annachis04/Oscilator-de-audiofrecventa-cu-semnal-sinusoidal/Documentatia_P1_CHIS _Anna_432B.pdf

Universitatea Națională de Știință și Tehnologie POLITEHNICA București Facultatea E.T.T.I.
Anul universitar 2025-2026

# Circuite electronice fundamentale 2 - Proiect

# Proiectarea și realizarea unui

# oscilator de audiofrecvență cu

# semnal sinusoidal

N=1

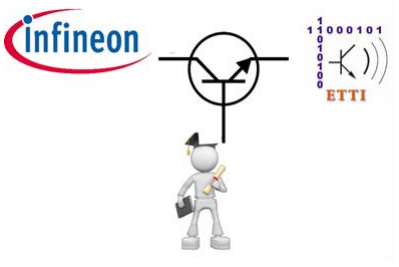
[picture p1: figure]

Coordonatori stiințifici: | Student: Chiș Anna
Prof. dr. ing Dragoș Dobrescu | Grupa:432B
Ș.l. dr. ing. Mădălin Moise

## Cuprins

Capitolul 5: Proiectarea și realizarea circuitului în tehnologie

5.2 Imaginea structurii de interconectare (layer-ul electric TOP).....19

### 5.3 Imaginea structurii de interconectare

### 5.4 Imaginea măștii de inscripționare (layer-ul neelectric SSTOP)...20

5.5.Imaginea măștii de protecție (layer-ul neelectric SMTOP).........20

## Capitolul 1: Date de proiectare

## Oscilator sinusoidal de audiofrecvență

Să se proiecteze şi realizeze practic un oscilator sinusoidal de audiofrecvenţă având următoarele caracteristici:

- Tensiunea de alimentare poate fi unipolară (Vcc=11 V) sau bipolară
(Vcc=11 V, Vee=-Vcc). Semnalizarea prezenței tensiunii cu LED;
- Tensiune de ieșire sinusoidală reglabilă cu amplitudinea va fi cuprinsă în intervalul 0-100 [mV];
- Frecvența semnalului de ieșire reglabilă în intervalul 100-1000 [Hz];
- Rezistența de sarcină 400 Ω (sarcină pur rezistivă);
- Pentru reţeaua de reacţie pozitivă se va utiliza unul dintre circuitele: Wien, Dublu Gama, Dublu T, T podit, cu 3 celule RC de defazare;

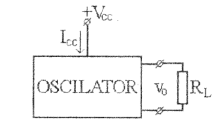
[picture p2: figure]

Schema bloc a oscilatorului

## Capitolul 2: Introducere în Proiectarea Oscilatoarelor

Proiectarea schemei unui oscilator se bazează pe principii fundamentale de electronică, integrând concepte studiate în cadrul disciplinelor DE (Dispozitive Electronice) și CEF (Circuite Electronice Fundamentale).

În esență, un oscilator este un sistem cu autoîntreținere, structurat pe trei piloni principali:

1. Elementul activ (Amplificatorul): Oferă energia necesară menținerii semnalului.
2. Reacția pozitivă (Calea de regenerare): Responsabilă pentru inițierea și susținerea oscilațiilor.
3. Reacția negativă (Calea de control): Utilizată pentru stabilizarea amplitudinii și controlul performanțelor amplificatorului.

### 2.1. Configurația și Funcționarea Sistemului

În practică, un oscilator este adesea privit ca un amplificator cu reacție negativă căruia i se aplică o buclă suplimentară de reacție pozitivă. Această arhitectură hibridă asigură atât stabilitatea punctului de funcționare, cât și condițiile necesare procesului de oscilație.

Rolul Reacției Pozitive

Reacția pozitivă este
mecanismul critic prin care o fracțiune din semnalul de ieșire este reinjectată la intrare în fază cu semnalul original. Acest proces de feedback cumulativ are următoarele implicații:

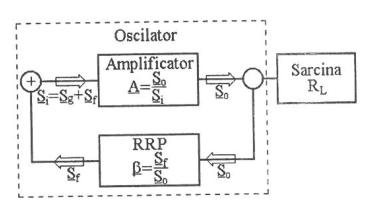
[picture p3: figure]

- Auto-susținerea: Semnalul readus la intrare este re-amplificat succesiv, ducând la o creștere progresivă a amplitudinii.
- Intrarea în saturație: Spre deosebire de amplificatoarele liniare, unde reacția pozitivă este evitată pentru a preveni instabilitatea, în cazul oscilatoarelor, acest fenomen este exploatat controlat. Deoarece un amplificator fizic nu poate depăși tensiunile de alimentare (+Vcc și VEE), semnalul se va stabiliza oscilând între aceste limite de saturație.

Rețeaua de Reacție Pozitivă (RRP)

RRP-ul nu este doar un simplu conductor, ci un circuit selectiv (de obicei un filtru RC) cu două funcții vitale:

1. Amorsarea oscilațiilor: Sistemul pornește de la zgomotul termic inerent componentelor electronice. RRP selectează o componentă spectrală din acest zgomot și o trimite spre amplificare până la atingerea regimului permanent.
2. Determinarea frecvenței: Prin structura sa constructivă (valorile componentelor R și C), rețeaua impune frecvența precisă la care defazajul este nul, definind astfel frecvența de lucru a oscilatorului.

Concluzie: Rețeaua de reacție pozitivă funcționează ca un selector de frecvență și un motor al sistemului, transformând un zgomot aleatoriu într-un semnal periodic stabil.

### 2.2. Reacția Negativă (RRN)

Spre deosebire de reacția pozitivă, care favorizează instabilitatea necesară amorsării, reacția negativă are rolul de a stabiliza sistemul. Aceasta se opune creșterii necontrolate a semnalului, permițând ajustarea precisă a factorului de amplificare al oscilatorului.

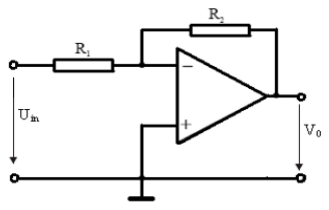
[picture p4: figure]
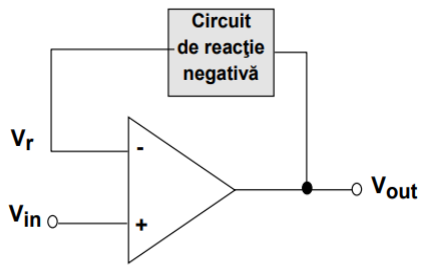
[picture p5: figure]

Figura 1 | Figura 2

În configurația din Figura 2, borna neinversoare este conectată la masă, în timp ce semnalul este aplicat pe borna inversoare. În această structură:

- Rezistorul R1 limitează curentul de intrare.
- Rezistorul R2 stabilește bucla de reacție negativă.

Relația fundamentală pentru tensiunea de ieșire (Vo) și amplificarea în buclă închisă (A) este:

V0 =

−R2
R1
* Uin | A = V0 Uin = −R2
R1

Prezența semnului minus confirmă natura inversoare a etajului, indicând un defazaj de 180 de grade între intrare și ieșire.

Funcțiile principale ale RRN în cadrul oscilatorului:

1. Stabilizarea amplificării: Menține câștigul sistemului la o valoare fixă, independentă de variațiile parametrilor interni ai componentelor.
2. Controlul liniarității: Prin introducerea unor elemente de limitare în bucla de reacție, se previne intrarea brutală în saturație, asigurând un semnal de ieșire cu distorsiuni minime.

### 2.3. Amplificatorul Operațional și Arhitectura Sistemului

Pentru implementarea circuitului, utilizăm un amplificator operațional (AO), caracterizat prin:

- Impedanță de intrare foarte mare: Previne încărcarea etajelor anterioare.
- Impedanță de ieșire redusă: Permite transferul optim de putere către sarcină.
- Câștig în buclă deschisă ridicat: Esențial pentru procesarea semnalelor de mică amplitudine.

Un aspect practic pentru identificarea reacțiilor este conexiunea la pinii AO:

- Conexiunea la borna inversoare (-) generează reacție negativă.
- Conexiunea la borna neinversoare (+) generează reacție pozitivă.

Proiectarea Etajelor Cascadata

Pentru a obține un oscilator performant, vom structura circuitul în trei blocuri funcționale:

- Blocul de intrare: Proiectat cu o impedanță ridicată pentru a izola sursa de semnal (sau zgomotul termic inițial) și a nu perturba etajele următoare.
- Blocul de amplificare: Reprezintă "inima" sistemului. Acesta trebuie să furnizeze un câștig suficient pentru a compensa atenuările din rețeaua de reacție, respectând Criteriul lui Barkhausen pentru menținerea oscilațiilor sinusoidale.
- Blocul de ieșire (Buffer): Are rolul de adaptare a sarcinii. Acesta nu modifică amplitudinea semnalului, ci asigură curentul necesar la ieșire, protejând etajul de amplificare de variațiile impedanței de sarcină.

## Capitolul 3: Considerente teoretice

## 3.1 Condiția de oscilație Barkhausen

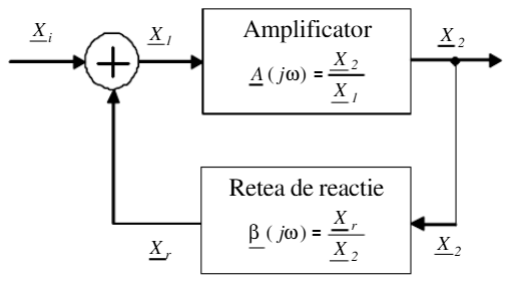
[picture p6: figure]

Notăm cu A câștigul amplificatorului, iar cu β funcția de transfer a RRP, dependentă de frecvență și care fixează frecvența de oscilație. Circuitul devine un oscilator, daca îndepărtând semnalul de excitație(Sg=0), la ieșire se obține un semnal (So, finit). Acest lucru semnifică faptul că aplificarea cu reacție Af = Sg/ So = A / (1- βA) este infinita, rezultând:
A * β(0)= 1 - condiția Barkhausen Pe de altă parte, câștigul este independent de frecvență. Ca urmare, se impune suplimentar ca Im{ β(0)}= 0 ; notând modulele câștigului și funcției de transfer cu A, respectiv β( 0) condiția Barkhausen se explicitează: A*β(0)=1
| A+B= 0/2π
A si B reprezintă defazajele introduse la f=f0 de amplificator, rspectiv RRP.
Ținând cont de factorii ce duc la variația amplificării (temperatura, tensiunea de alimentare etc.) sunt posibile urmatoarele cazuri: A<1/ β(0), cand nu apar oscilații;
A<1/ β(0), când semnalul de la ieșire este distorsionat; A=1/ β(0), când nu se realizează amorsarea/ stabilizarea oscilațiilor.
Amorsarea presupune debutul oscilațiilor,creșterea amplitudinii semnalului de frecvență 0 până la valoarea Vosc – amplitudinea în regim permanent de oscilație. Stabilizarea presupune la rândul ei menținerea amplitudiniii la valoarea Vo=Vosc= const.
Concret, amorsarea și stabilizarea oscilațiilor sunt posibile dacă si numai dacă amplificarea este o funcție descrescătoare de amplitudinea semnalului generat la ieșire, lucru ilustrat și în figura.
Din calcule teoretice rezulta necesitatea unei amplificari mai mare de 3 pentru schema pe care ne propunem sa o facem si anume, un oscilator cu punte Wien.

## 3.2. Limitarea amplitudinii de oscilație

Mecanismul de limitare asigura mentinerea oscilatiilor la un nivel controlat. Astfel, exista mai multe metode:
- Un termistor sau bec, ce se bazeaza pe variatia rezistentei.
- Un dipol din diode, ori 2 diode simple antiparalel, ori 2 zener in antiserie
- Un control automat cu TEC-J

- In esenta, toate astea de mai sus vor intra in relatia amplificarii 1+r2/r1, putand fi ori termenul r2 ori r1. Acestia variind intr-un anumit fel, automat si amplificarea va varia si ea. De obicei noi vrem ca amplificarea sa scada la un moment dat si sa se mentina la o valoare stabilita de noi, pentru a evita saturarea.

## 3.3. Rețele RC

## - Rețeaua Wien

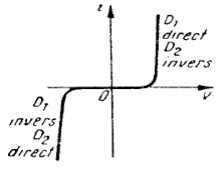
[picture p7: figure]

Rețeaua Wien este ilustrată în figura, schema din stânga pentru transfer în tensiune, cu functia de transfer in stanga
Presupunând această rețea conectată la un amplificator ideal de tensiune, se observă că raporturile R1/ R2 și C2/ C1 trebuie menținute constante atunci când se reglează frecvența, în

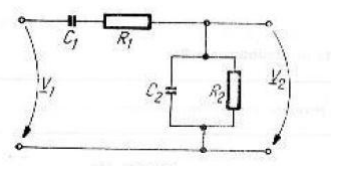
[picture p8: figure]

caz contrar modificându-se valoarea amplificării si deci amplitudiea oscilațiilor.
Se preferă deci să se aleagă R1= R2= R și C2= C1= C, astfel încât frecvența de oscilație devine 1/ (2*π*R*C), amplificarea în tensiune din condiția Barkhausen fiind egală cu 3.Folosind programul de simulare LTspice, putem observa curba de atenuare specifică.

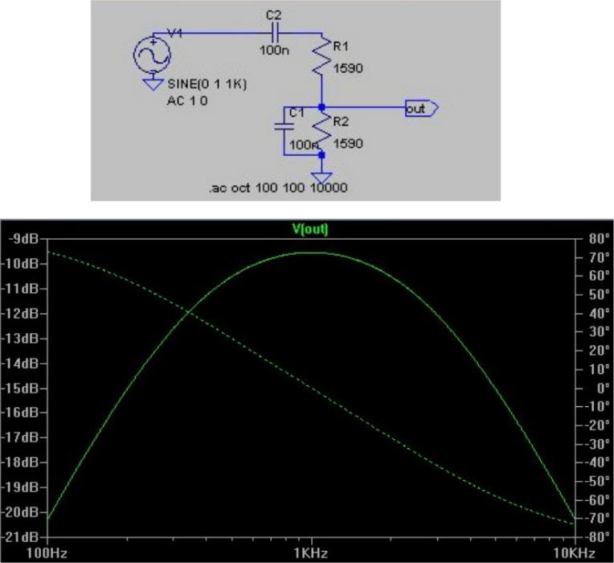
[picture p9: figure]

## Rețeaua dublu T

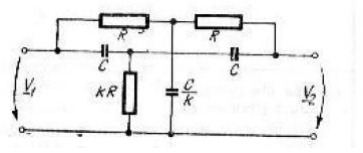
[picture p10: figure]

Figura de mai sus ilustrează rețeaua dublu T, cu transfer în tensiune, iar funcția de transfer este si ea prezentată mai jos:

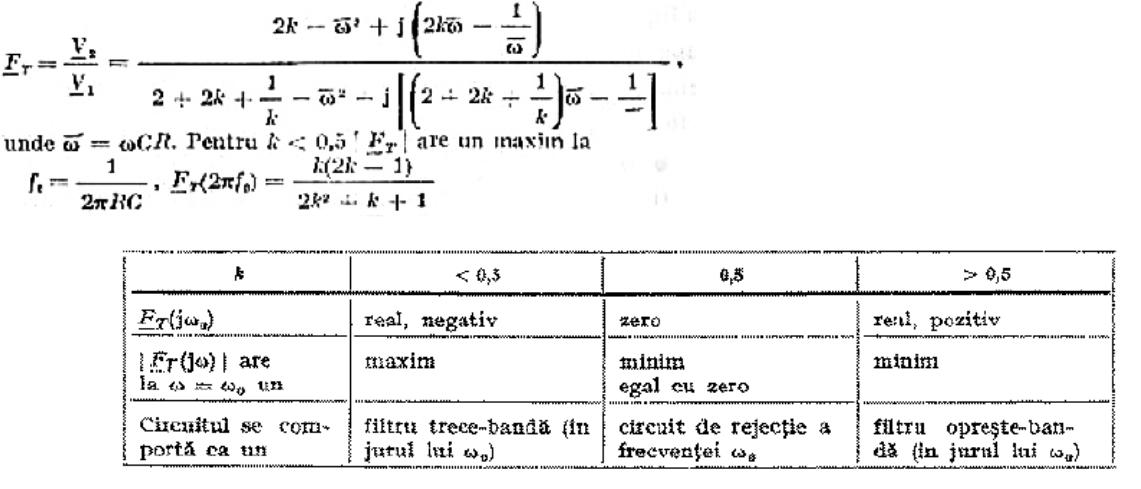
[picture p11: figure]

La frecvența caracteristică, funcția de transfer în tensiune este reală, fiind pozitivă pentru k>0,5, negativă pentru k<0,5 și zero pentru k=0,5. Cele 3 cazuri sunt sintetizate in imaginea de mai sus. Daca rețeaua operează ca un filtru trece-bandă, atunci ea poate fi folosită în bucla de reacție pozitivă a unui oscilator. Dacă rețeaua lucrează ca un filtru oprește-bandă, atunci ea trebuie inclusă în bucla de reacție negativă, oscilatorul mai necesitând o buclă de reacție pozitivă neselectivă.
Simulările pentru o rețea dublu T, pentru k=0,159 sunt prezentate mai jos, folosind LTspice:

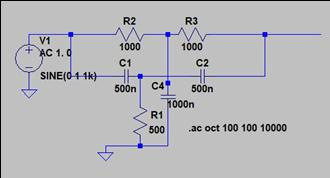
[picture p12: figure]

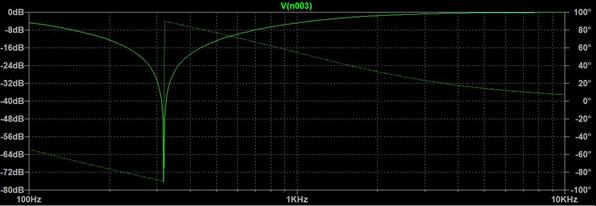
[picture p13: figure]

Rețeaua T-podit

Rețeaua T-podit are proprietăți asemănătoare cu rețeaua dublu T, cu o selectivitate mai slabă, dar cu avantajul că frecvența se poate varia cu un potențiometru, ca la rețeaua Wien.Schema este prezentă mai jos pentru un k=0,054 și funcția de transfer alăturată.

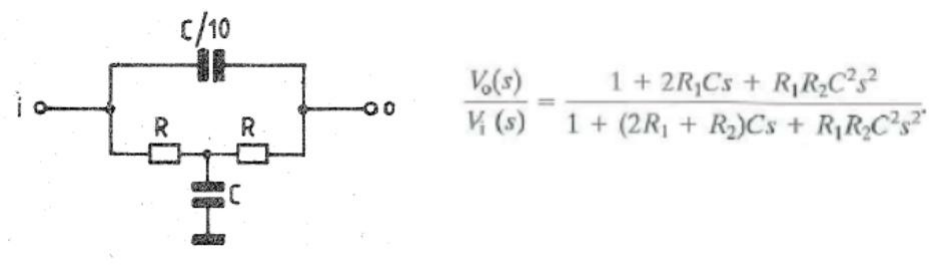
[picture p14: figure]
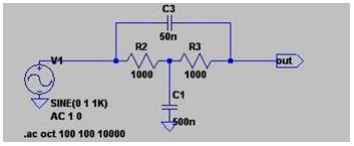
[picture p15: figure]

## Capitolul 4: Proiectare 4.1. Schema electrica a montajului

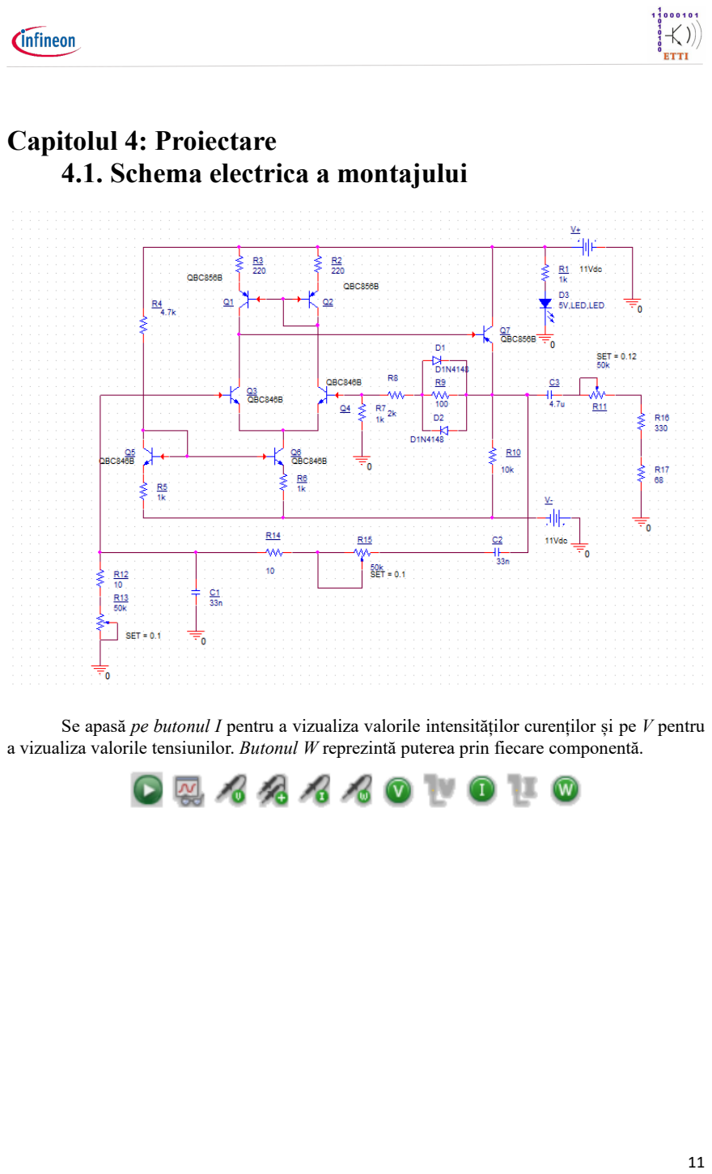
[picture p16: page 11]

Se apasă pe butonul I pentru a vizualiza valorile intensităților curenților și pe V pentru a vizualiza valorile tensiunilor. Butonul W reprezintă puterea prin fiecare componentă.

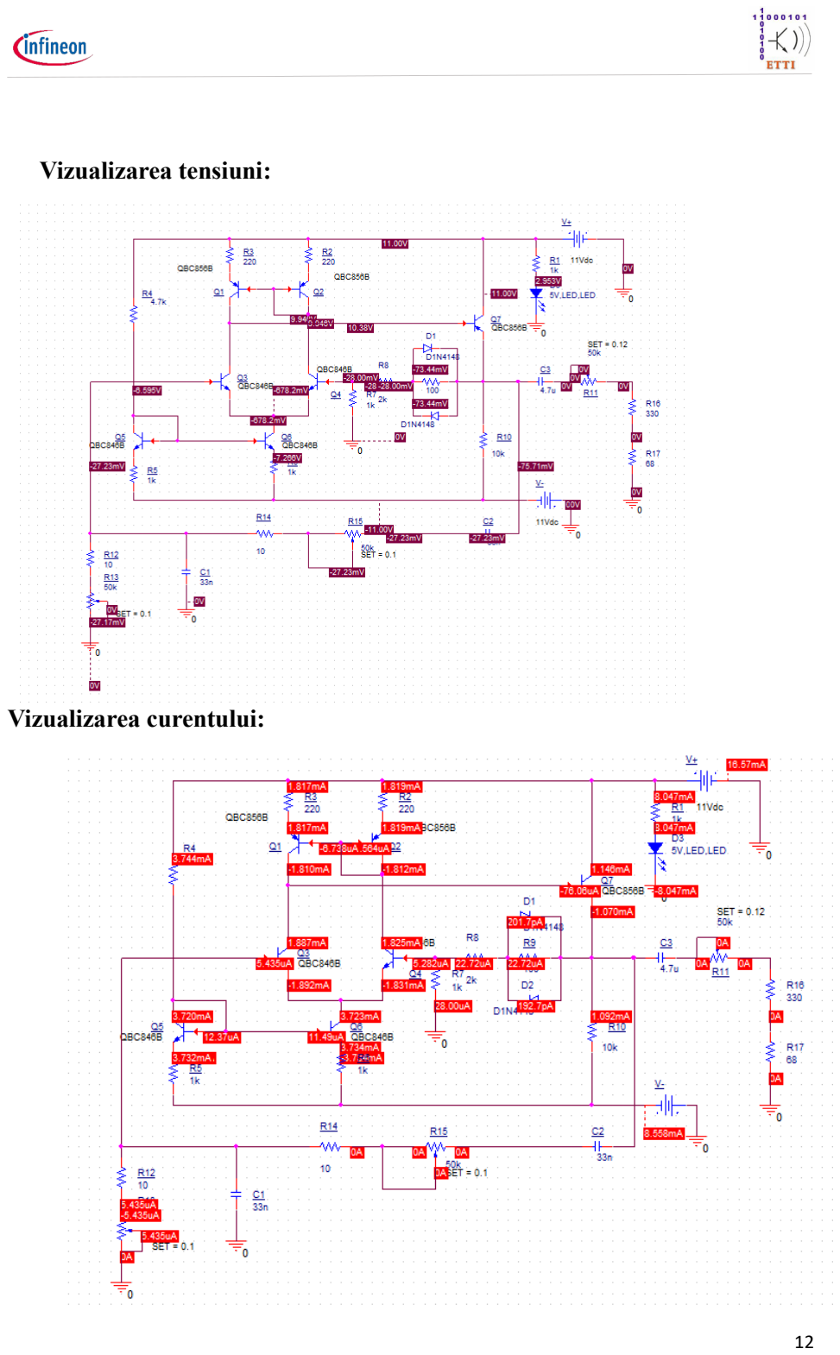
[picture p17: page 12]

Vizualizarea tensiuni:

Vizualizarea curentului:

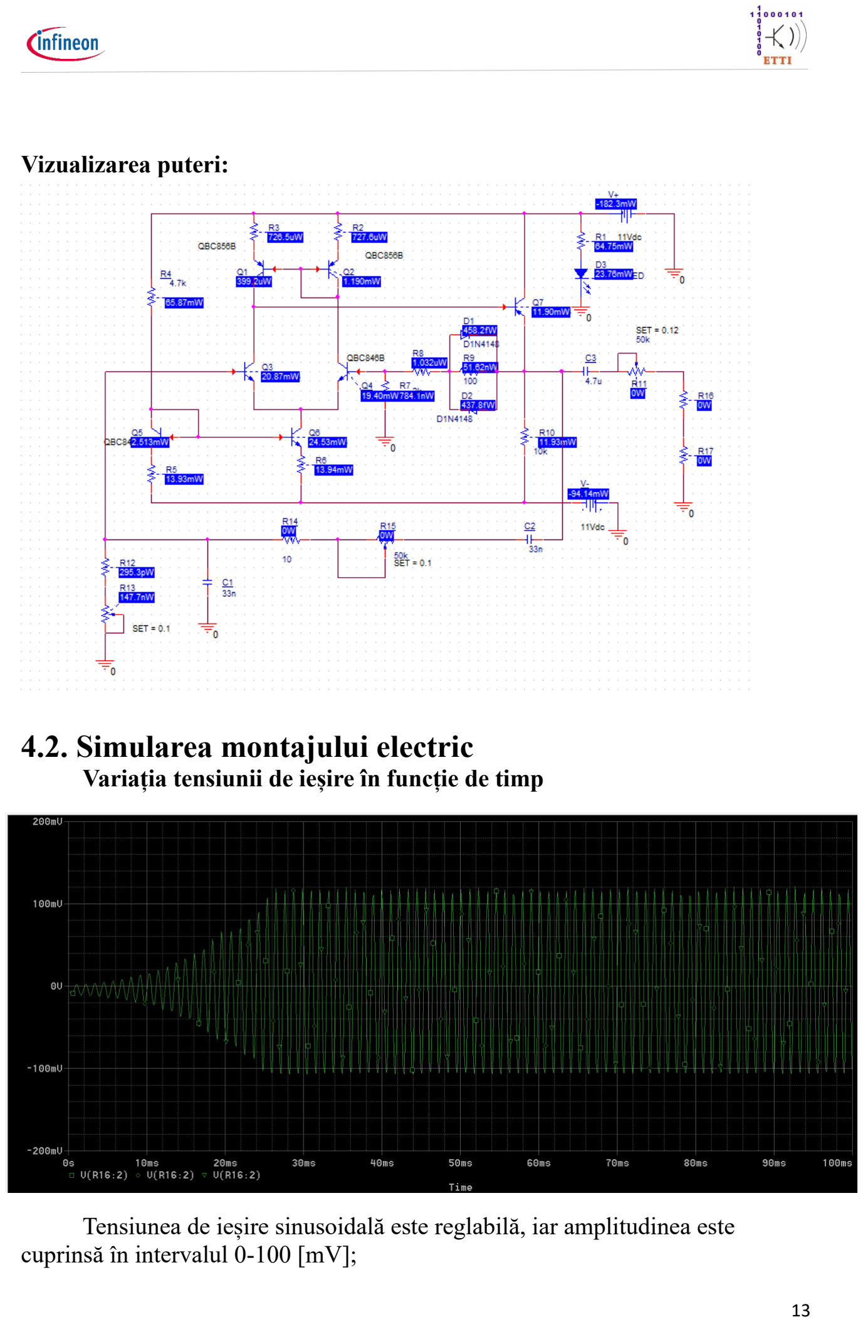
[picture p18: page 13]

Vizualizarea puteri:

## 4.2. Simularea montajului electric

Variația tensiunii de ieșire în funcție de timp

### Tensiunea de ieșire sinusoidală este reglabilă, iar amplitudinea este

cuprinsă în intervalul 0-100 [mV];

Frecvența de oscilatie
Frecvența semnalului de ieșire este reglabilă în intervalul 100-1000 [Hz];

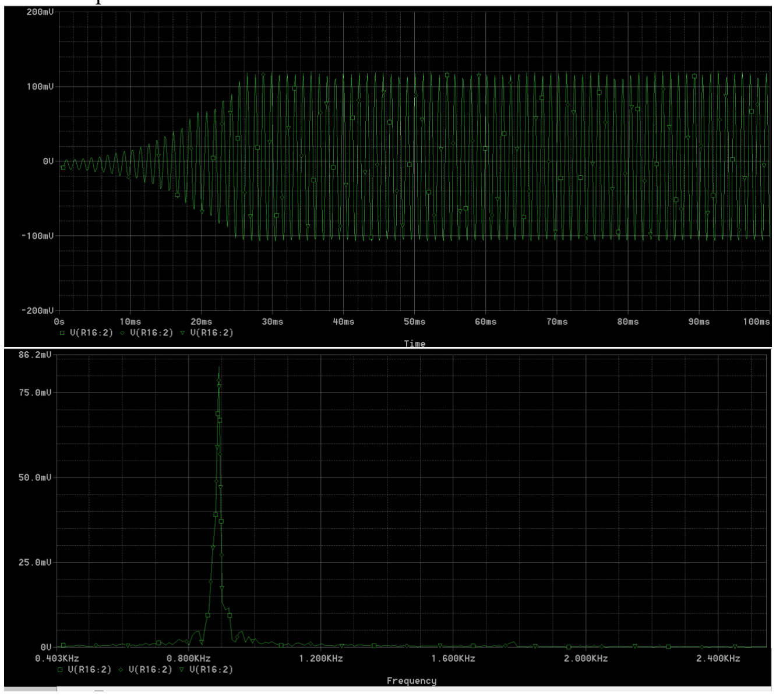
[picture p19: figure]

### Semnalul pentru f=1 kHz:

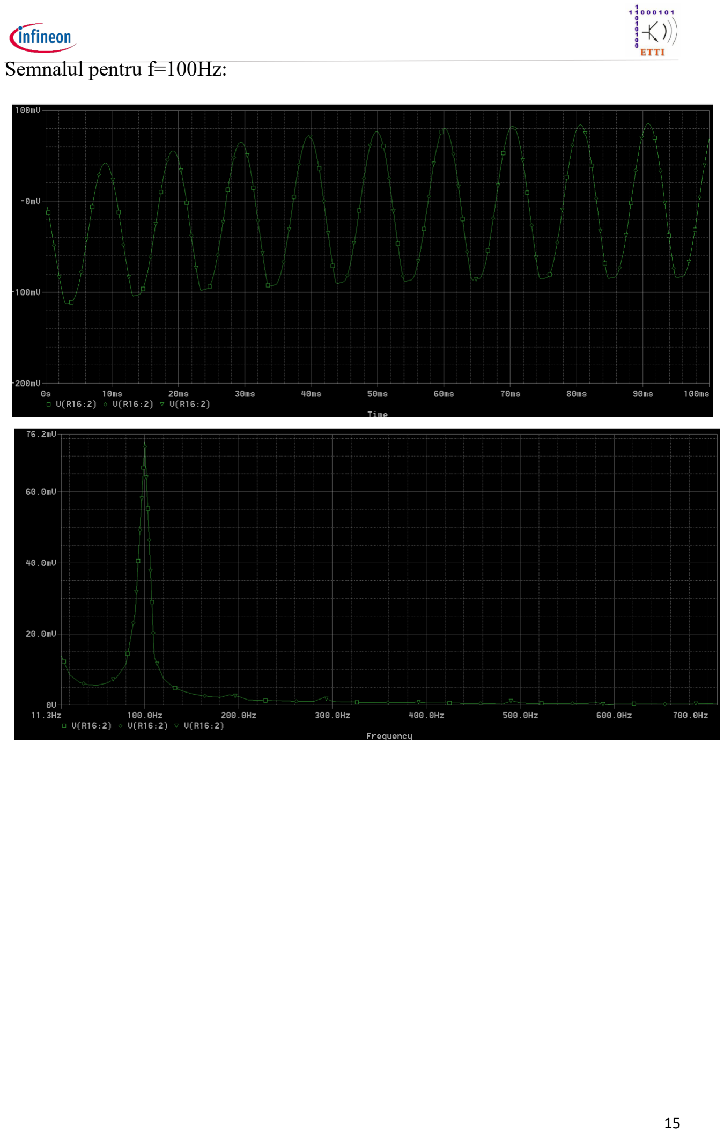
[picture p20: page 15]

### Semnalul pentru f=100Hz:

## 4.3. Punctul static de funcționare

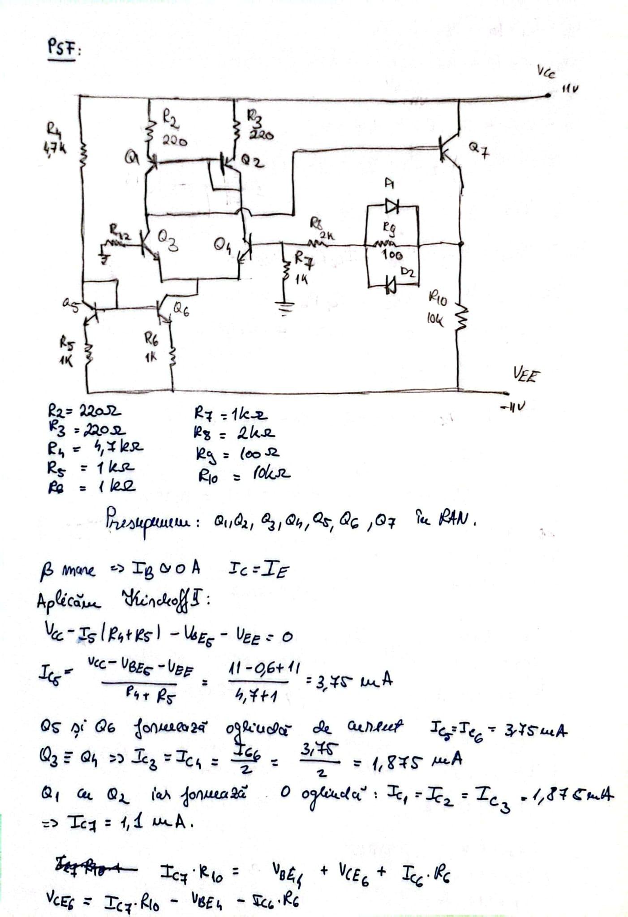
[picture p21: figure]
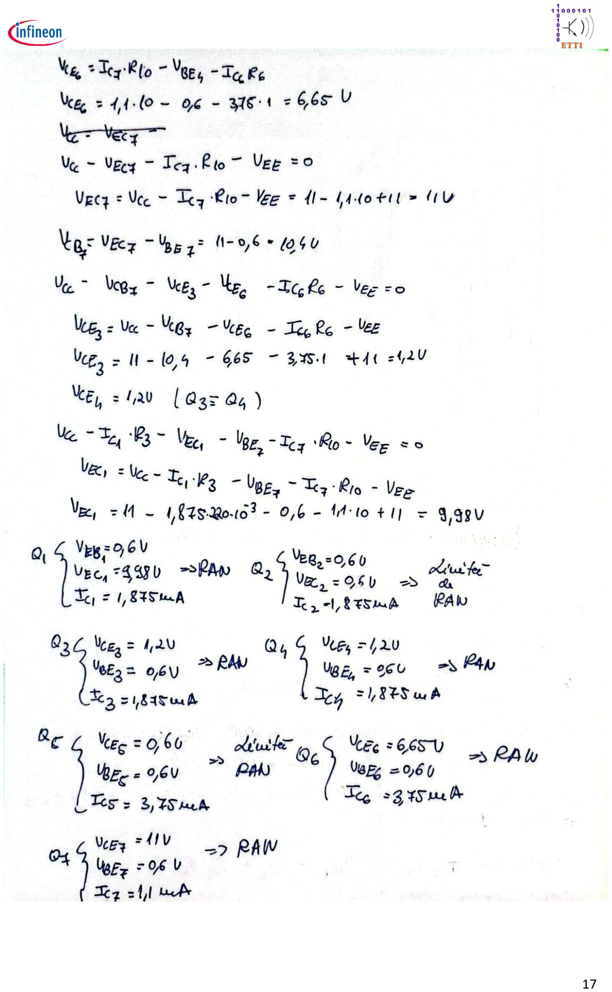
[picture p22: page 17]

## 4.4. Bill of Materials

Nr. Crt. | Nume | Catalog | Cod distrib | Nume prod | Prod | Clasă | Cantitate
5 | 10 | (LINK) (https://www.tme.eu/ro/details/smd0805-10r/rezistente-smd-0805/royal-ohm/0805s8j0100t5e/) | SMD0805-10R-5% | 0805S8J0100T5E | ROYAL OHM | rezistor | 2
9 | 68 | (LINK) (http://www.tme.eu/ro/details/smd0805-68r-1%25/rezistente-smd-0805/royal-ohm/0805s8f680jt5e/) | SMD0805-68R-1% | 0805S8F680JT5E | ROYAL OHM | rezistor | 1
11 | 100 | (LINK) (https://www.tme.eu/ro/details/smd0805-100r/rezistente-smd-0805/royal-ohm/0805s8j0101t5e/) | SMD0805-100R-5% | 0805S8J0101T5E | ROYAL OHM | rezistor | 1
13 | 220 | (LINK) (http://www.tme.eu/ro/details/smd0805-220r-1%25/rezistente-smd-0805/royal-ohm/0805s8f2200t5e/) | SMD0805-220R-5% | 0805S8J0221T5E | ROYAL OHM | rezistor | 2
14 | 330 | (LINK) (https://www.tme.eu/ro/details/smd0805-330r/rezistente-smd-0805/royal-ohm/0805s8j0331t5e/) | SMD0805-330R-5% | 0805S8J0331T5E | ROYAL OHM | rezistor | 1
20 | 1k | (LINK) (https://www.tme.eu/ro/details/smd0805-1k/rezistente-smd-0805/royal-ohm/0805s8j0102t5e/) | SMD0805-1K-5% | 0805S8J0102T5E | ROYAL OHM | rezistor | 4
23 | 2k | (LINK) (https://www.tme.eu/ro/details/smd0805-2k/rezistente-smd-0805/royal-ohm/0805s8j0202t5e/) | SMD0805-2K-5% | 0805S8J0202T5E | ROYAL OHM | rezistor | 1
28 | 4.7k | (LINK) (https://www.tme.eu/ro/details/smd0805-4k7/rezistente-smd-0805/royal-ohm/0805s8j0472t5e/) | SMD0805-4K7-5% | 0805S8J0472T5E | ROYAL OHM | rezistor | 1
33 | 10k | (LINK) (https://www.tme.eu/ro/details/smd0805-10k/rezistente-smd-0805/royal-ohm/0805s8j0103t5e/) | SMD0805-10K-5% | 0805S8J0103T5E | ROYAL OHM | rezistor | 1
54 | 50k | (LINK) (http://www.tme.eu/ro/details/3314g-1-503e/trimere-smd-cu-o-singura-tura/bourns/) | 3314G-1-503E | 3314G-1-503E | BOURNS | potențiometru | 3
68 | 33nF | (LINK) (https://www.tme.eu/ro/details/vj0805y333kxacw1bc/condensatoare-mlcc-smd-0805/vishay/) | VJ0805Y333KXACW1BC | VJ0805Y333KXACW1BC | VISHAY | condensator | 2
75 | 4.7uF | (LINK) (https://www.tme.eu/ro/details/cl21a475kaqnnng/condensatoare-mlcc-smd-0805/samsung/) | CL21A475KAQNNNG | CL21A475KAQNNNG | SAMSUNG | condensator | 1
77 | 4148 | (LINK) (http://www.tme.eu/ro/details/1n4148-0805/diode-universale-smd/dc-components/cd4148ws0805c/) | 1N4148-0805 | CD4148WS(0805C) | DC Components | diodă pn | 2
78 | LED | (LINK) (https://www.tme.eu/ro/details/of-smd2012b/diode-led-smd-colorate/optoflash/) | OF-SMD2012B | OF-SMD2012B | OPTOFLASH | LED | 1
86 | PNP | (LINK) (http://www.tme.eu/ro/details/bc856b-dio/tranzistori-smd-pnp/diotec-semiconductor/bc856b/) | BC856B | BC856B | DIOTEC | tranzistor bipolar | 3
87 | NPN | (LINK) (https://www.tme.eu/ro/details/bc846b-dio/tranzistori-smd-npn/diotec-semiconductor/bc846b/) | BC846B | BC846B | DIOTEC | tranzistor bipolar | 4

## Capitolul 5: Proiectarea și realizarea circuitului în tehnologie SMD &PCB 5.1 Imaginea generală a modulului electronic în Layout

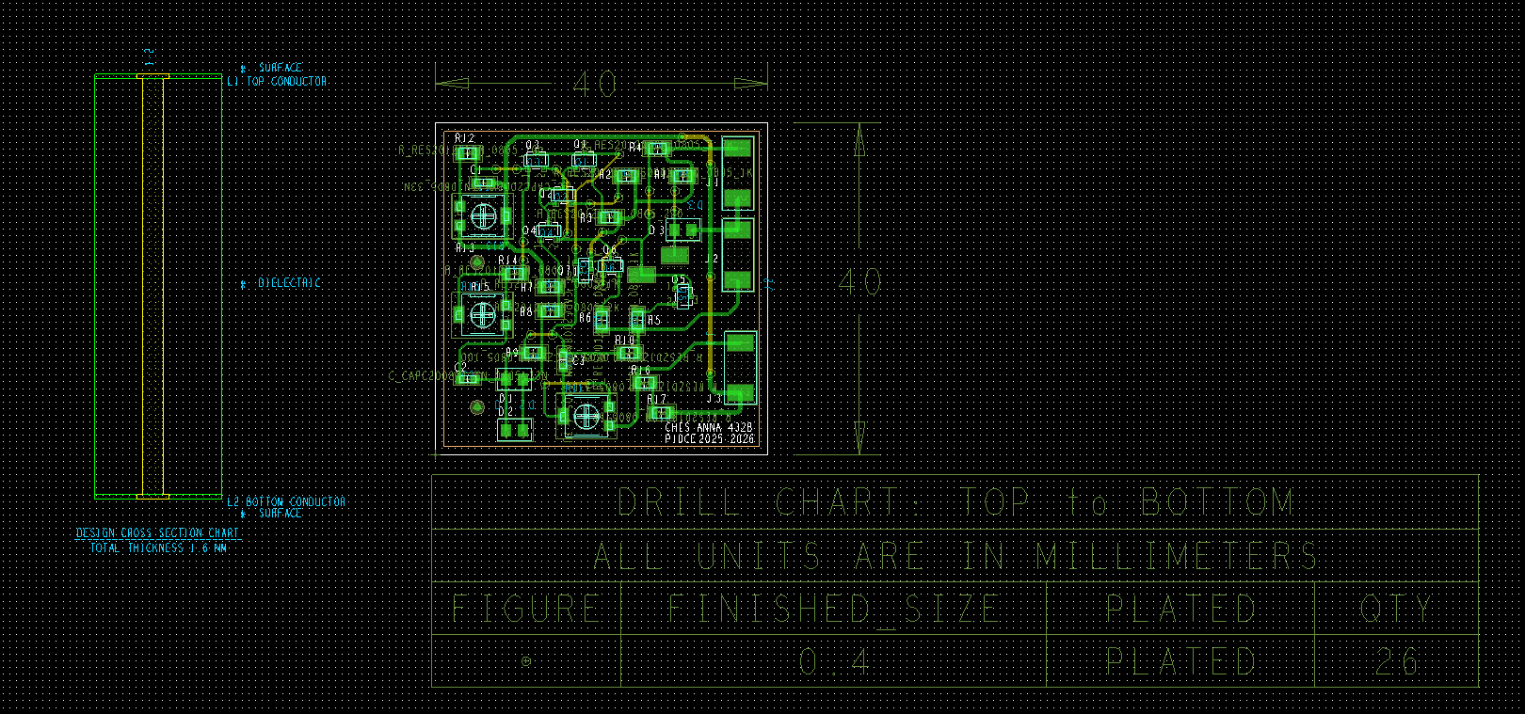
[picture p23: figure]

## 5.2 Imaginea structurii de interconectare (layer-ul electric TOP)

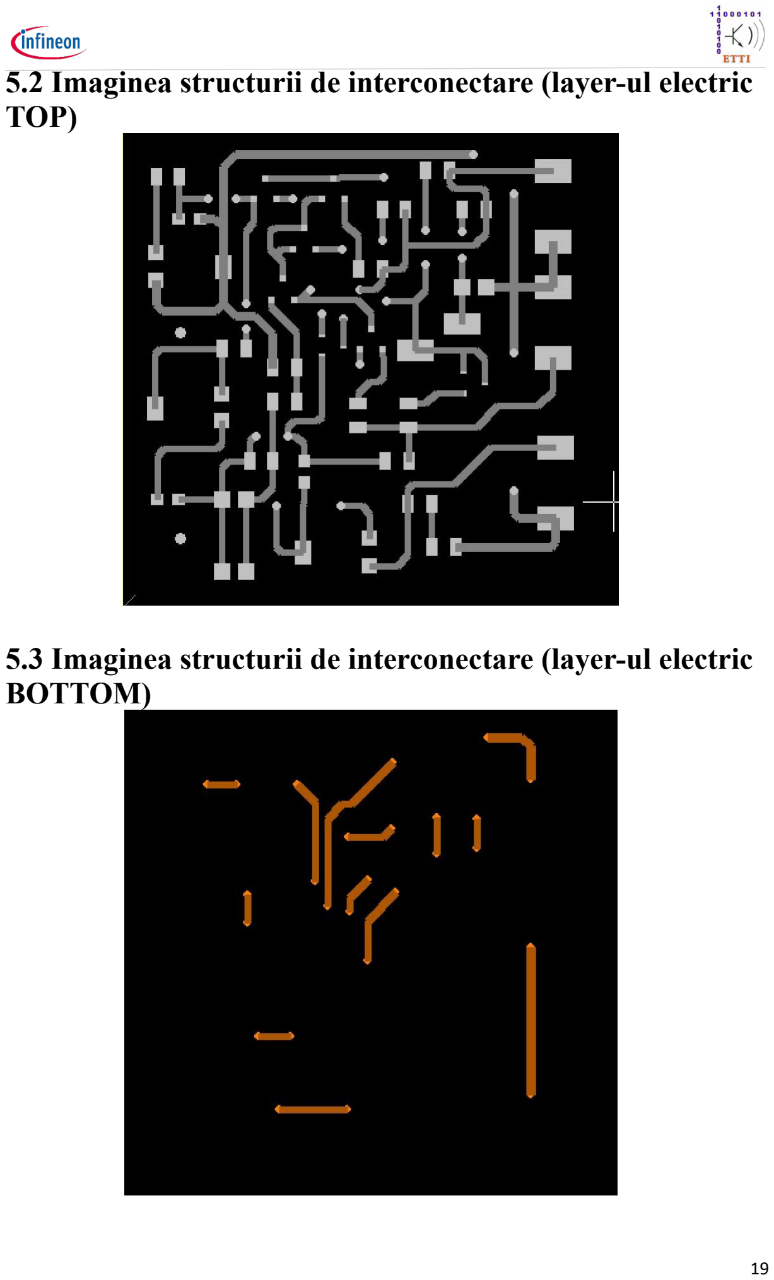
[picture p24: page 19]

## 5.3 Imaginea structurii de interconectare (layer-ul electric BOTTOM)

## 5.4 Imaginea măștii de inscripționare (layer-ul neelectric

## SSTOP)

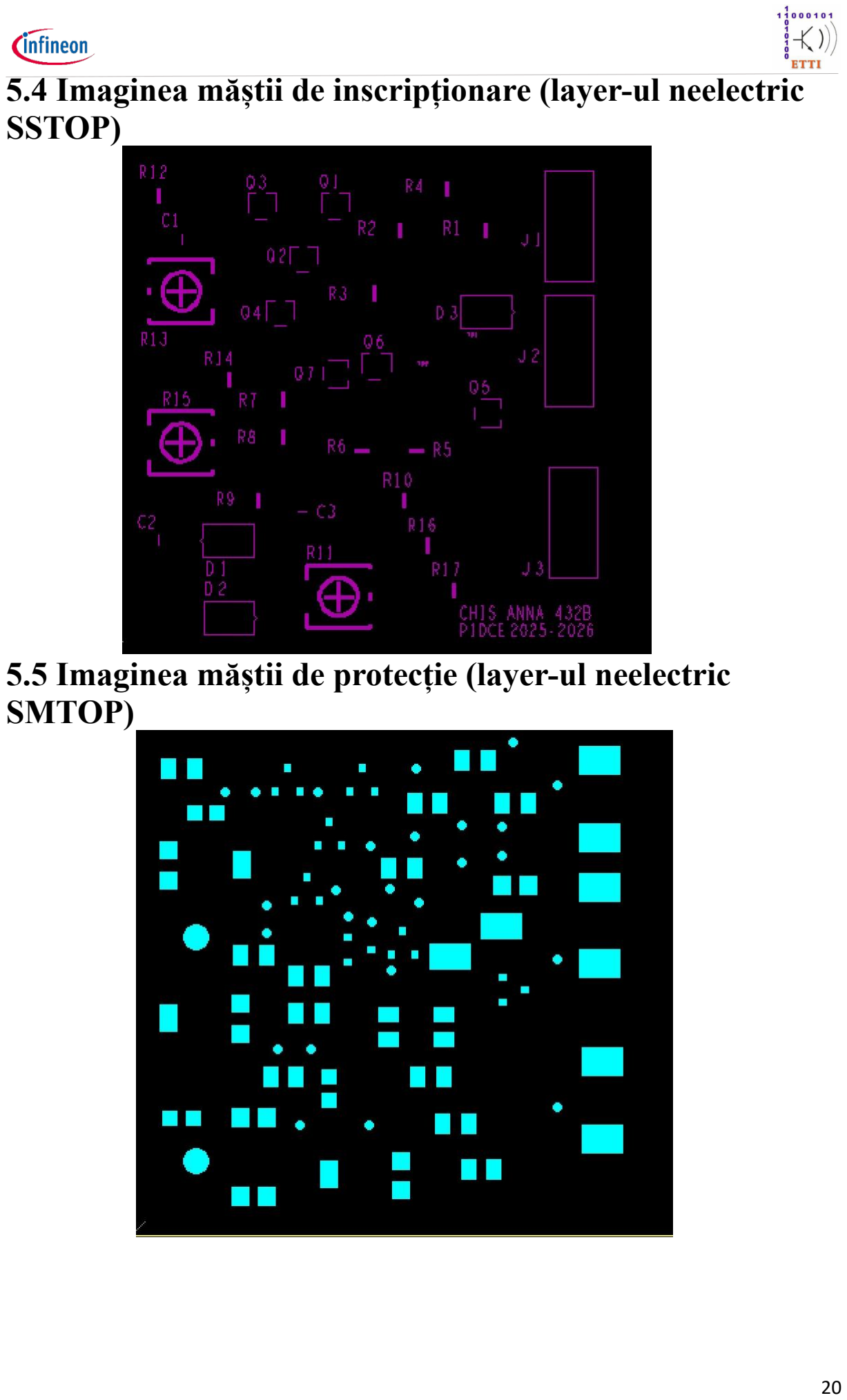
[picture p25: page 20]

## 5.5 Imaginea măștii de protecție (layer-ul neelectric

## SMTOP)

## 5.6 Imaginea șablonului (layer-ul neelectric SPTOP)

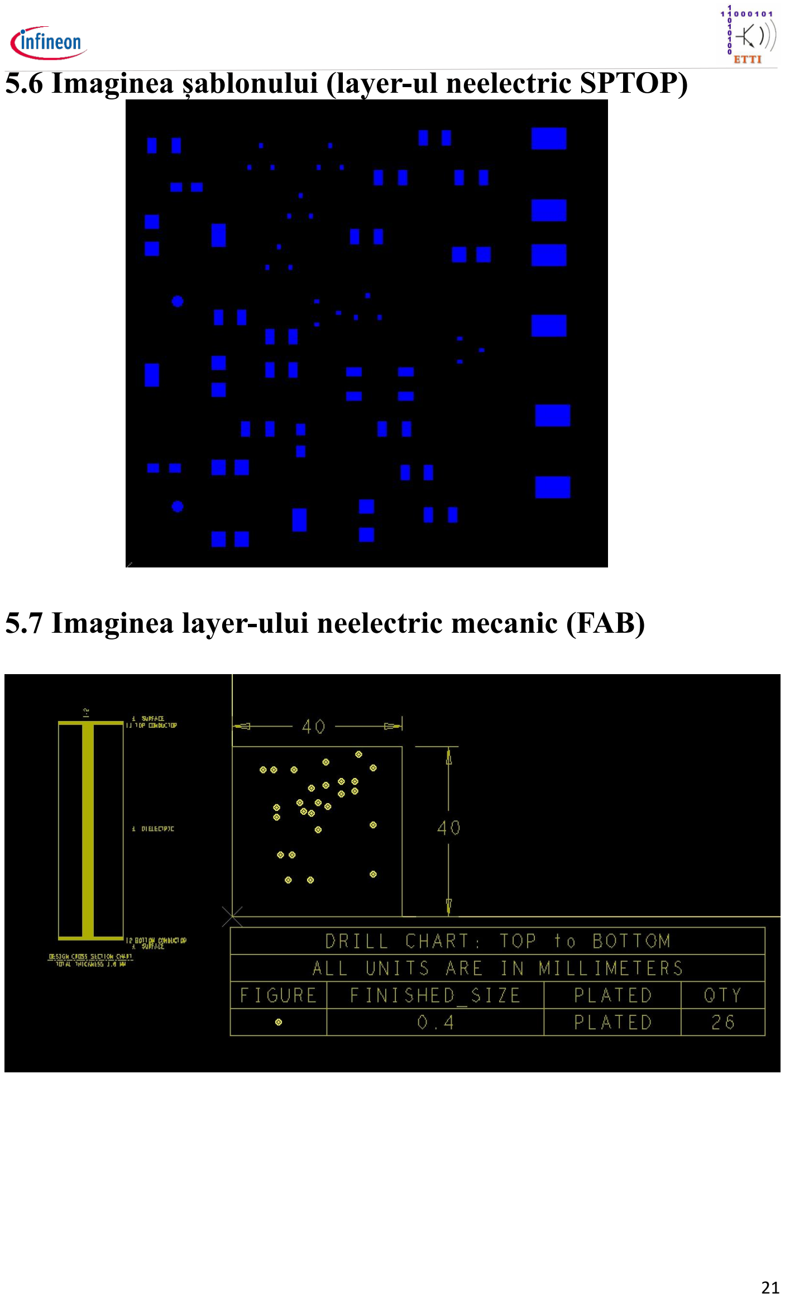
[picture p26: page 21]

## 5.7 Imaginea layer-ului neelectric mecanic (FAB)

## 5.8. Procesul de Asamblare și Lipire

Implementarea fizică a proiectului presupune asamblarea componentelor pe cablajul imprimat prin realizarea unor conexiuni electrice și mecanice durabile. Acest proces se bazează pe utilizarea unui aliaj de lipire tip SnAgCu, aplicat cu ajutorul unei stații de lipit, al cositorului și al fluxului. Deși multe tipuri de cositor includ deja un nucleu de flux în centrul firului pentru a simplifica procedura, utilizarea unui agent chimic suplimentar este adesea necesară pentru o pregătire riguroasă a suprafețelor. Rolul principal al fluxului este acela de a decapa terminalele, eliminând oxizii și impuritățile care ar putea compromite calitatea îmbinării metalice.
În ceea ce privește procedura de lucru, menținerea unei temperaturi constante de aproximativ 370°C la nivelul vârfului de lipit este esențială pentru a asigura o fuziune optimă fără a supraîncălzi componentele sensibile. O bună practică pentru întreținerea echipamentului constă în păstrarea unui strat rezidual de aliaj pe vârful ciocanului de lipit la finalul lucrului; această metodă previne oxidarea metalului în perioadele de inactivitate.
Pentru situațiile în care este necesară corectarea unor erori sau îndepărtarea surplusului de aliaj, se apelează la tresa absorbantă. Utilizarea corectă a acesteia presupune poziționarea benzii de cupru între zona vizată și vârful încins al stației de lipit. Odată ce temperatura de topire este atinsă, aliajul este transferat prin capilaritate de pe PCB direct pe tresă. Este esențial ca această manevră să fie executată prin mișcări perpendiculare, evitând frecarea orizontală care ar putea duce la desprinderea accidentală a pad-urilor de cupru de pe substratul izolator al circuitului.

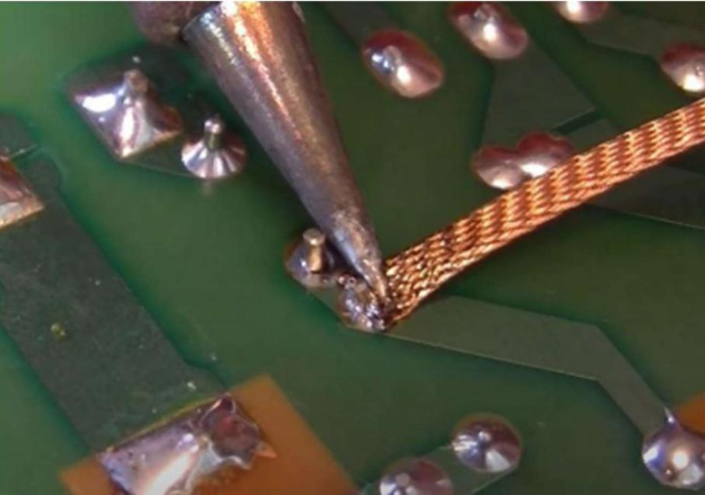
[picture p27: figure]

## Capitolul 6: Manual de Utilizare

Oscilatorul de audiofrecvență cu semnal sinusoidal este un dispozitiv de precizie, proiectat pentru a genera semnale stabile în condiții specifice de operare. Pentru a asigura o funcționare optimă, acesta trebuie utilizat într-o configurație de alimentare bipolară, cu o tensiune de linie de 11V și o impedanță de sarcină 400 Ω

Instrucțiuni de Conectare și Utilizare:
- Alimentarea circuitului: Se va respecta polaritatea sursei de tensiune, conectând borna pozitivă la VCC (+11V), borna negativă la VEE (-11V) și borna de referință la GND (Masă).
- Manevrarea în siguranță: Se recomandă prinderea plăcii exclusiv de margini pentru a evita descărcările electrostatice sau deteriorarea mecanică a componentelor.
- Integritatea sistemului: Nu se recomandă modificarea valorilor componentelor sau înlocuirea acestora, deoarece orice abatere de la schema originală poate duce la instabilitatea semnalului sau ieșirea din parametrii de proiectare.
- Măsuri de protecție în funcționare: Se va evita atingerea contactelor electrice sau a componentelor în timpul alimentării, pentru a preveni perturbațiile parazite sau riscul de scurtcircuit.
- Condiții de mediu: Dispozitivul trebuie păstrat într-un mediu uscat, ferit de umiditate excesivă și de expunerea directă la radiații solare sau temperaturi extreme pe perioade îndelungate.
- Siguranță generală: Produsul conține componente de mici dimensiuni și terminale ascuțite; prin urmare, nu se va lăsa la îndemâna copiilor fără supravegherea unui adult.

## Capitolul 7: Concluzii

Proiectul a avut ca obiectiv principal analiza, proiectarea și verificarea prin simulare a unui oscilator sinusoidal de audiofrecvență realizat pe baza configurației cu Punte Wien. În cadrul lucrării a fost demonstrată validitatea teoretică a funcționării circuitului prin aplicarea criteriului Barkhausen, fiind confirmate condițiile necesare de fază și câștig pentru inițierea și menținerea oscilațiilor stabile.

Simulările efectuate au susținut pe deplin analiza teoretică, evidențiind obținerea unei forme de undă sinusoidale curate și stabile în intervalul de frecvență 100 Hz – 1 kHz. Totodată, s-a observat comportamentul liniar al etajului de amplificare cu tranzistoare bipolare, precum și rolul crucial al reacției negative în stabilizarea amplitudinii și reducerea distorsiunilor.

O etapă esențială a proiectului a fost realizarea layout-ului fizic și a planului de plantare pentru montajul componentelor SMD pe un PCB dedicat. Această fază a demonstrat capacitatea de a transpune schema electrică într-o implementare practică modernă, optimizată din punct de vedere al traseelor, al zgomotului electric și al integrării compacte. Utilizarea componentelor SMD a permis obținerea unui design mai robust, cu dimensiuni reduse și cu o dispunere eficientă a elementelor de reglaj.

În concluzie, proiectul îndeplinește integral cerințele temei atât din perspectiva proiectării, cât și a simulării. Schema electrică finală, împreună cu layout-ul realizat pentru montajul SMD, constituie o bază solidă pentru etapa următoare de realizare fizică și testare experimentală în laborator, asigurând premisele funcționării corecte a oscilatorului ca generator de semnal audio.

## Capitolul 8: Bibliografie

- G. Brezeanu, F. Draghici, F. Mitu, G. Dilimot, Circuite electronice fundamentale - probleme, Editura Rosetti Educational, Bucuresti, editia II–2008;
- G. Brezeanu, F. Drăghici, Circuite electronice fundamentale, Ed. Niculescu, Bucureşti, 2013;
- https://www.rasfoiesc.com/inginerie/electronica/
- https://electronics.stackexchange.com/
- https://sites.google.com/site/bazeleelectronicii/home/oscilatoare/4-oscilatorul-punte-wien
