annachis04/Oscilator-de-audiofrecventa-cu-semnal-sinusoidal/poze_layout/BO.jpg

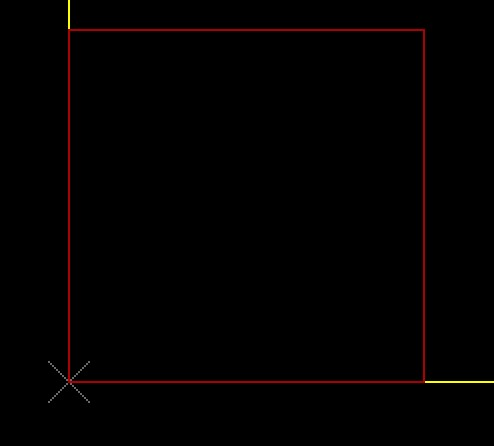
poze_layout/BO.jpg
