annachis04/Oscilator-de-audiofrecventa-cu-semnal-sinusoidal/poze_layout/BOT.jpg

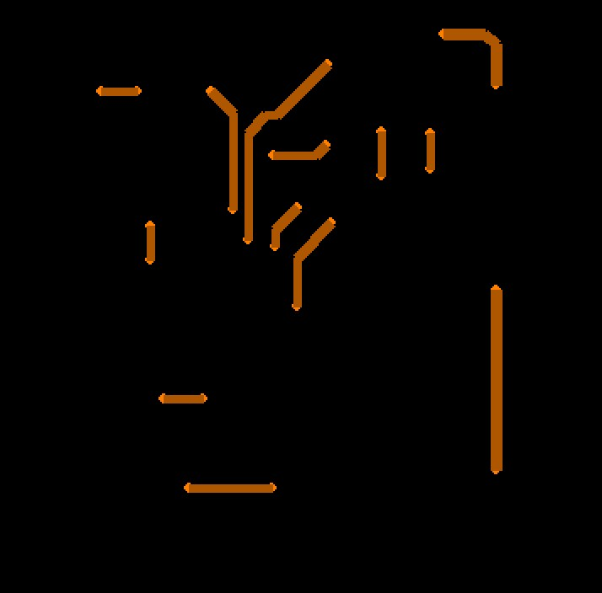
poze_layout/BOT.jpg
