annachis04/Oscilator-de-audiofrecventa-cu-semnal-sinusoidal/poze_layout/DRILL.jpg

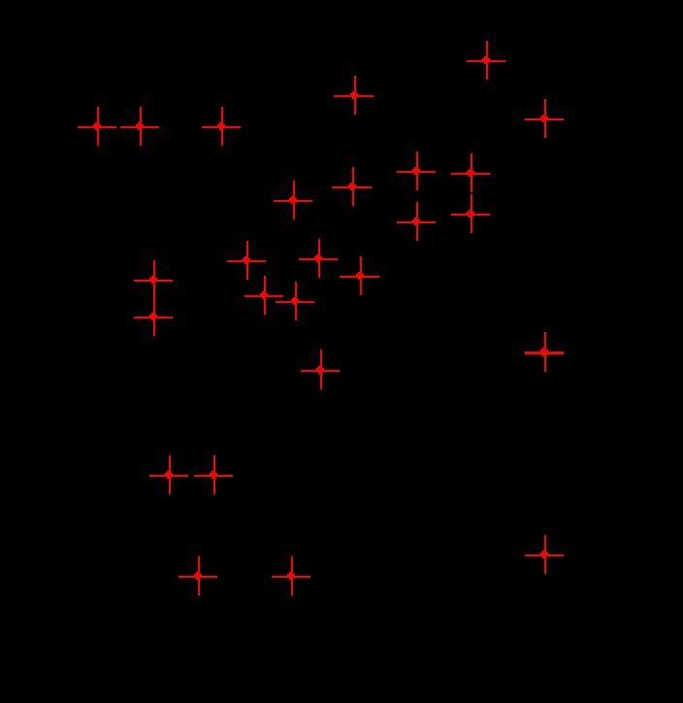
poze_layout/DRILL.jpg
