annachis04/Oscilator-de-audiofrecventa-cu-semnal-sinusoidal/poze_layout/FAB.jpg

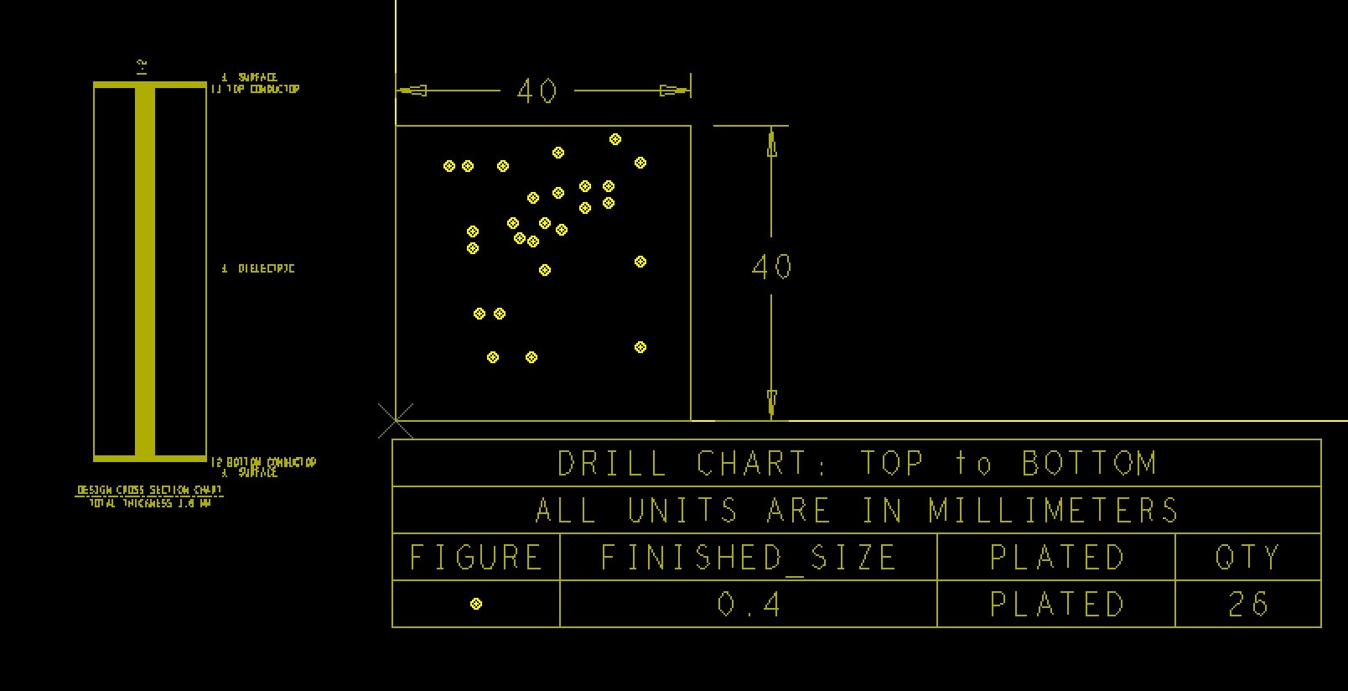
poze_layout/FAB.jpg
