annachis04/Oscilator-de-audiofrecventa-cu-semnal-sinusoidal/poze_layout/SMBOT.jpg

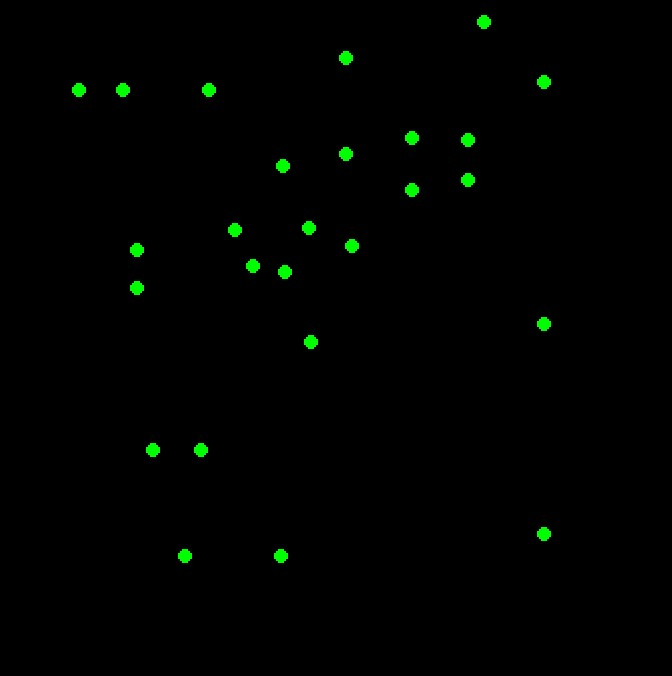
poze_layout/SMBOT.jpg
