annachis04/Oscilator-de-audiofrecventa-cu-semnal-sinusoidal/poze_layout/SMTOP.jpg

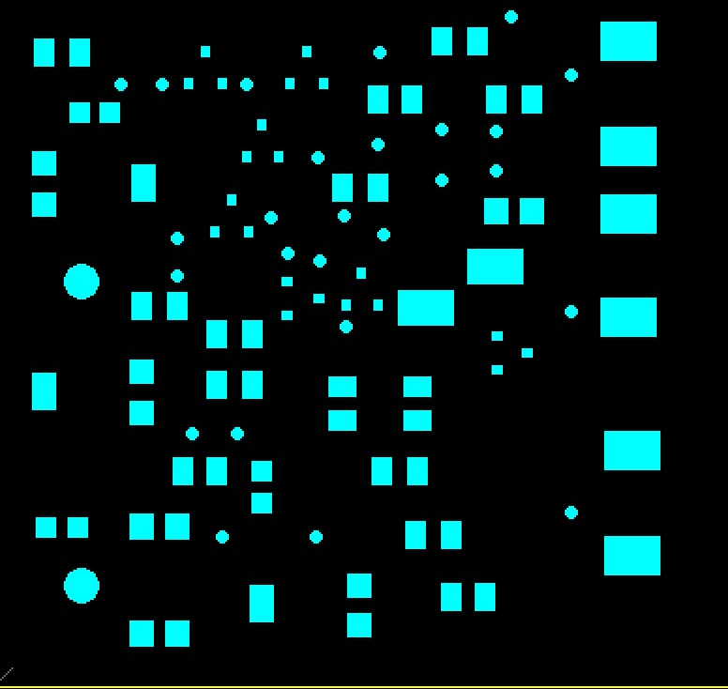
poze_layout/SMTOP.jpg
