annachis04/Oscilator-de-audiofrecventa-cu-semnal-sinusoidal/poze_layout/SMTOP_SSTOP.jpg

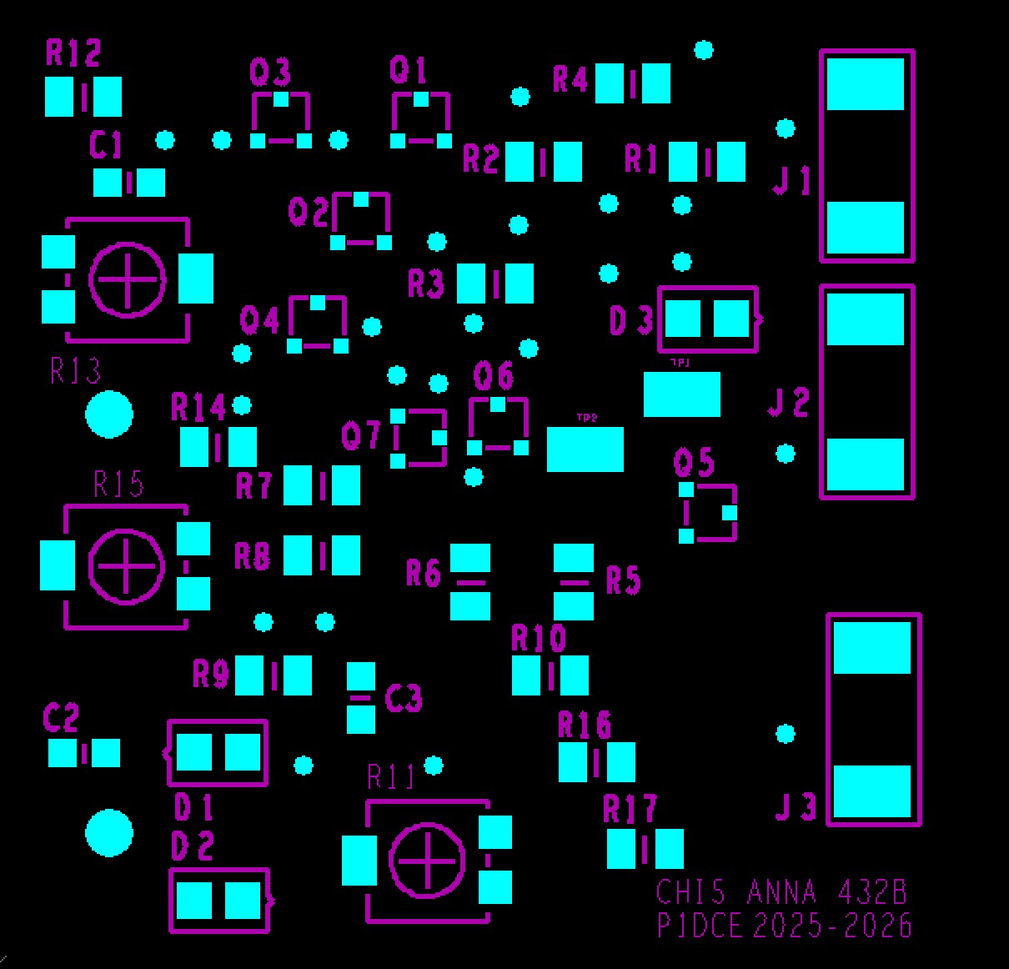
poze_layout/SMTOP_SSTOP.jpg
