annachis04/Oscilator-de-audiofrecventa-cu-semnal-sinusoidal/poze_layout/SPTOP.jpg

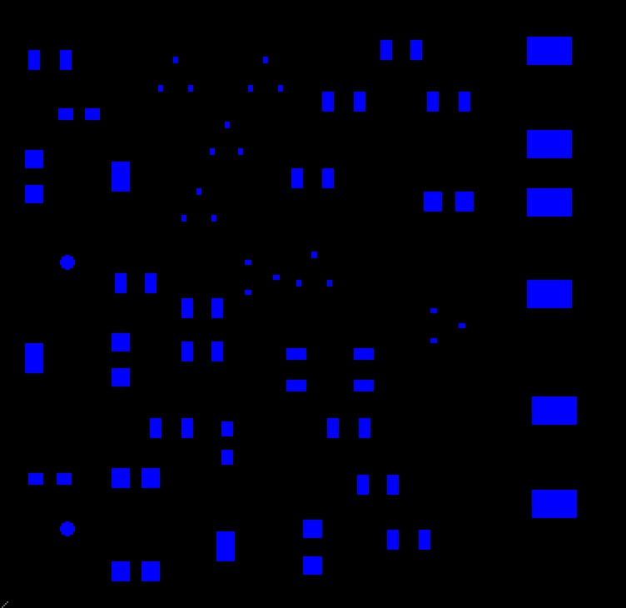
poze_layout/SPTOP.jpg
