annachis04/Oscilator-de-audiofrecventa-cu-semnal-sinusoidal/poze_layout/SSTOP.jpg

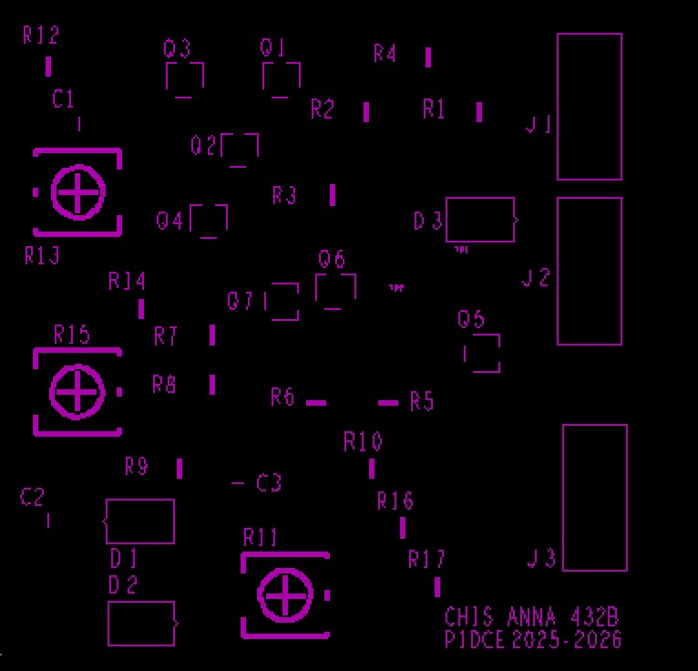
poze_layout/SSTOP.jpg
