annachis04/Oscilator-de-audiofrecventa-cu-semnal-sinusoidal/poze_layout/TOP.jpg

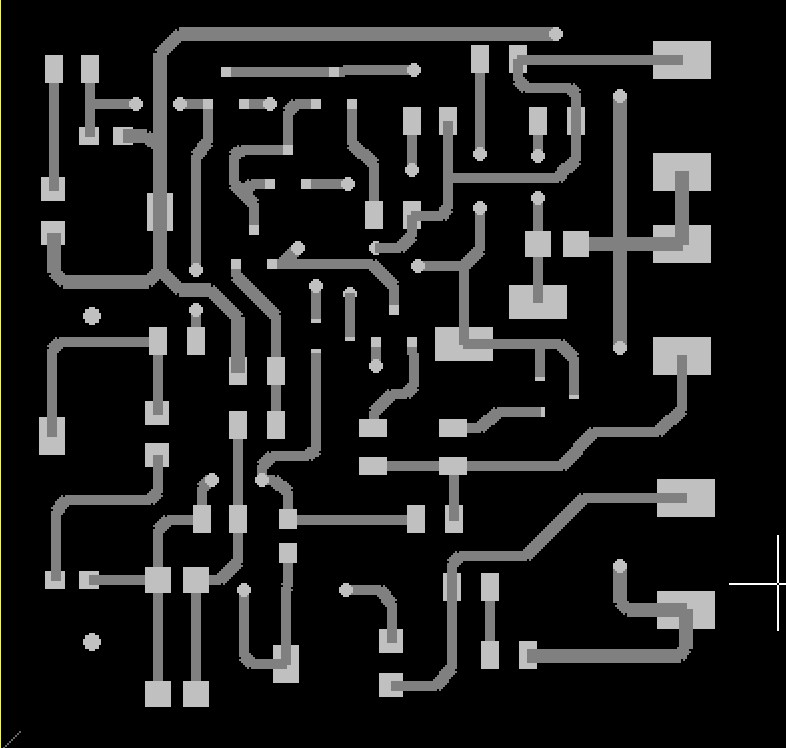
poze_layout/TOP.jpg
