annachis04/Oscilator-de-audiofrecventa-cu-semnal-sinusoidal/poze_layout/TOP_BOT.jpg

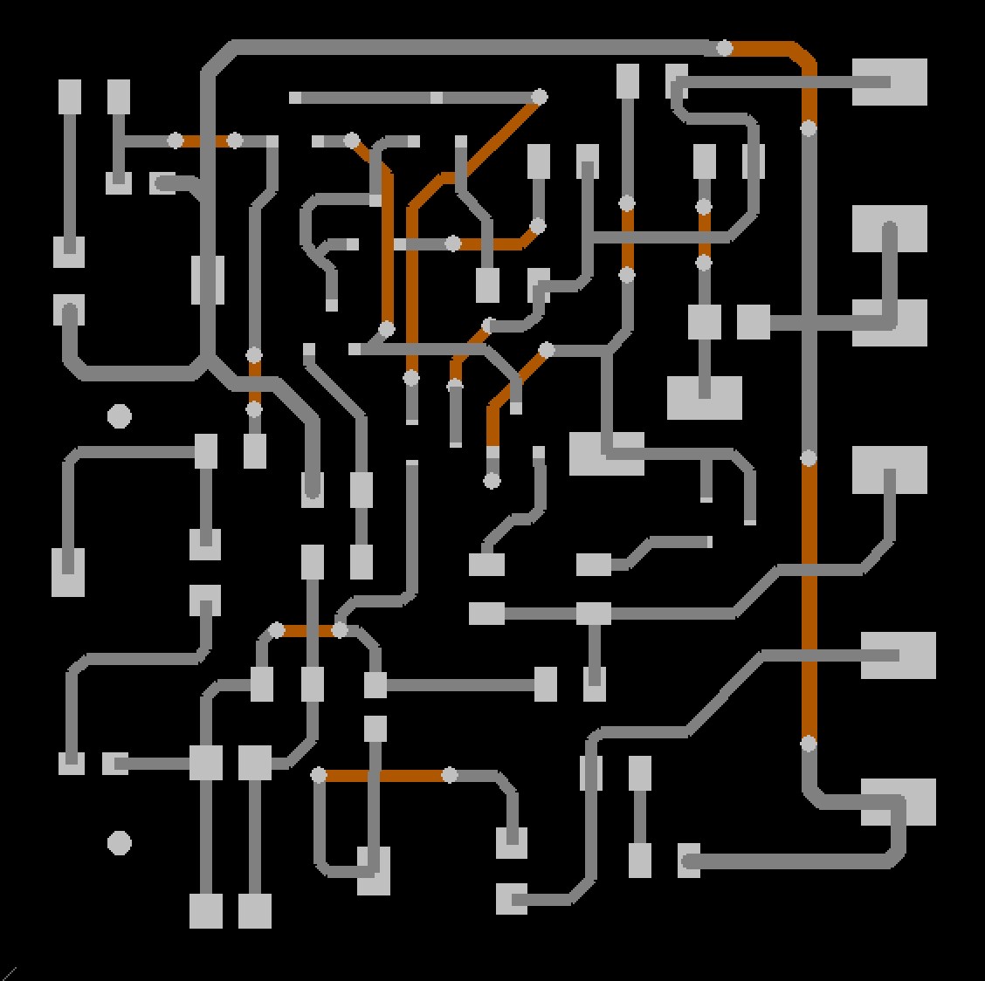
poze_layout/TOP_BOT.jpg
