annachis04/Oscilator-de-audiofrecventa-cu-semnal-sinusoidal/poze_layout/TOP_DRILL.png

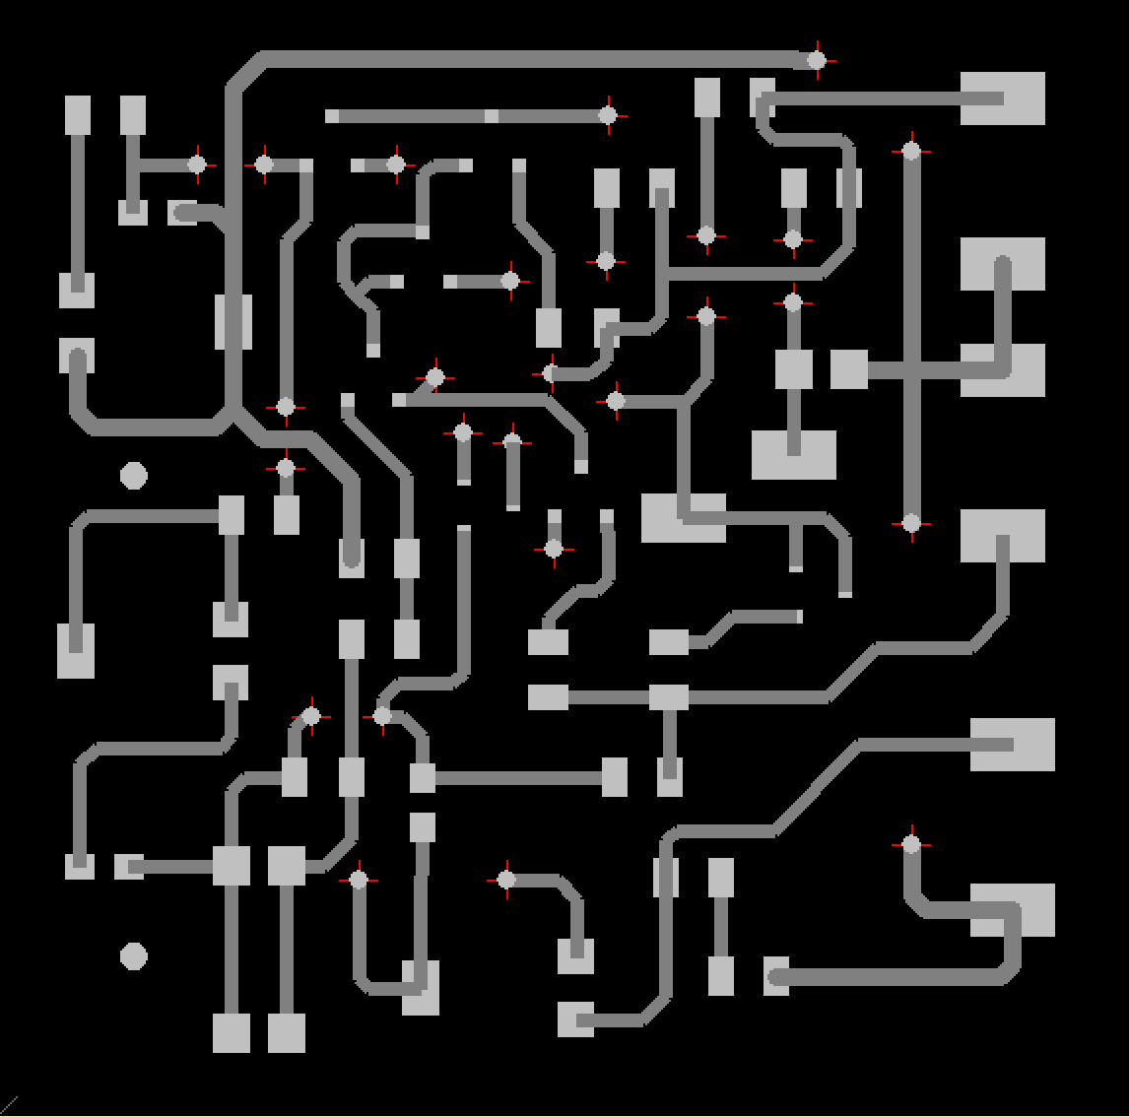
poze_layout/TOP_DRILL.png
