annachis04/Oscilator-de-audiofrecventa-cu-semnal-sinusoidal/poze_layout/TOP_SMTOP.jpg

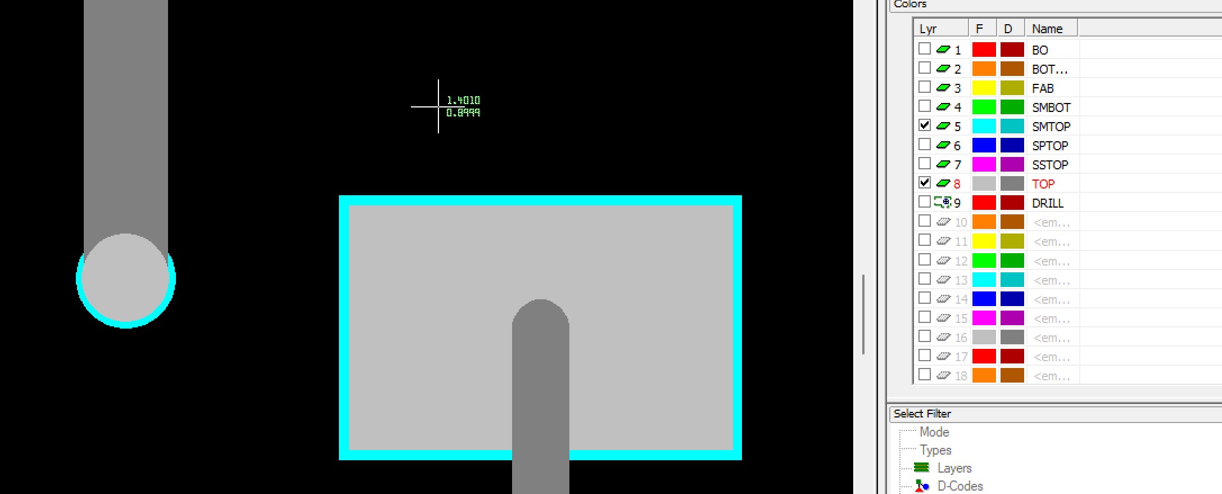
poze_layout/TOP_SMTOP.jpg
