annachis04/Oscilator-de-audiofrecventa-cu-semnal-sinusoidal/(list of files, drawings)

Other design files:
PCB/Project_partea1.dsn
PCB/Project_partea1.opj
SCHEMATIC/project_refacut2.dsn
SCHEMATIC/project_refacut2.opj
